jimbro1000/SuperSamFPGA/SuperSamFPGA.png

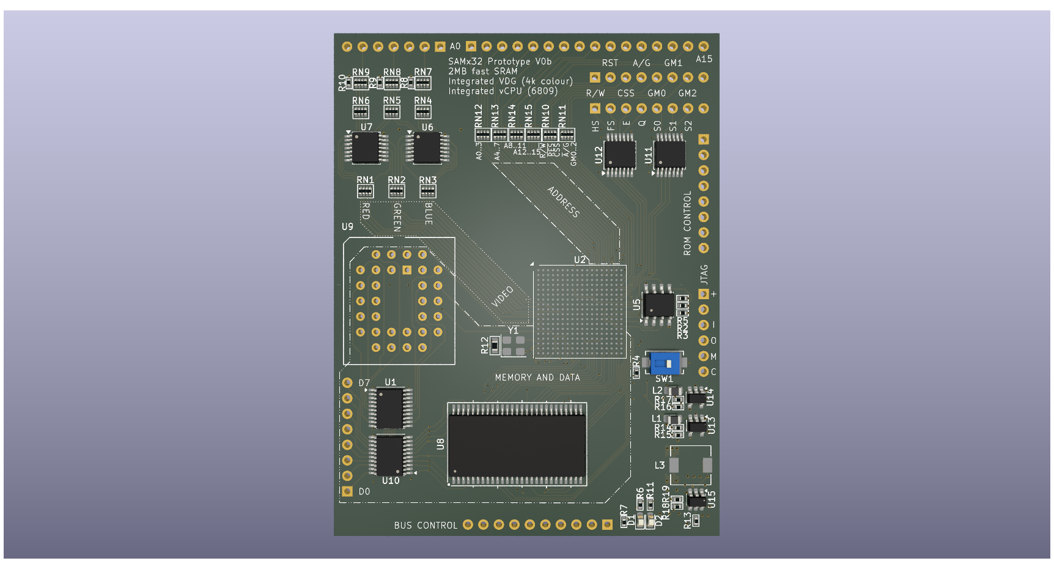
SuperSamFPGA.png
