jimbro1000/SuperSamFPGA/Library.3dModels/RGY0020A.stp

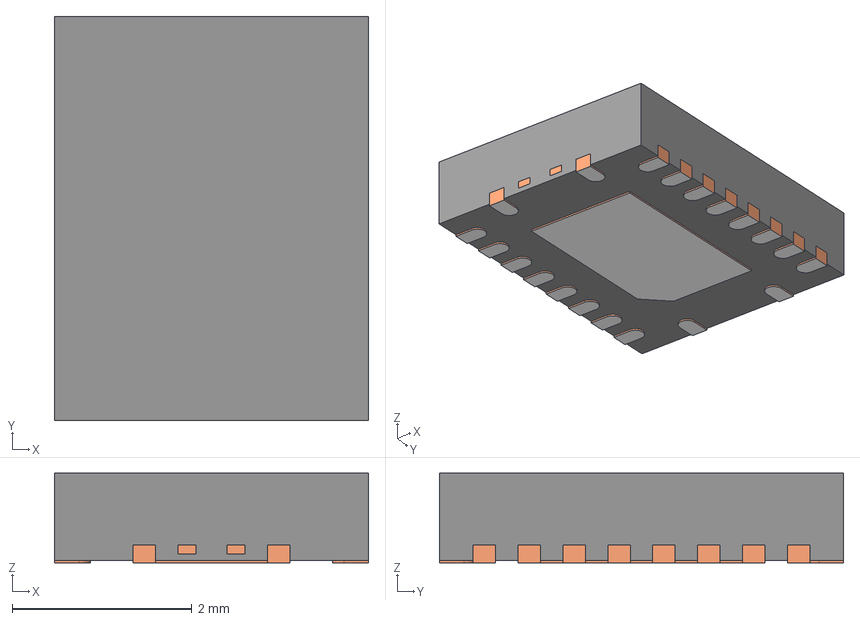
[picture p2: CAD file, 2026-04-23]
Library.3dModels/RGY0020A.stp
3.50 x 4.50 x 1.00 mm
BODY-QFN
FRAME-RGY0020A
PIN1-ID
