jimbro1000/SuperSamFPGA/Library.3dModels/MD-40SM.step

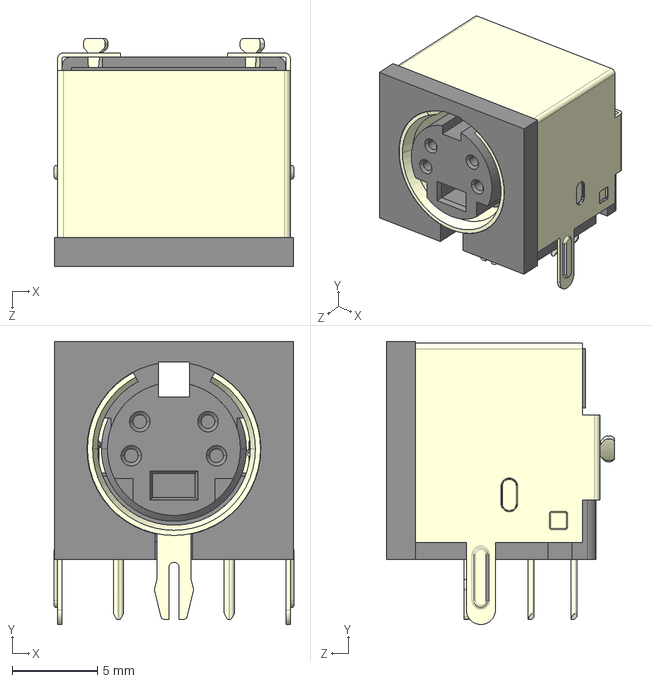
[picture p3: CAD file, 2026-04-23]
Library.3dModels/MD-40SM.step
14.1 x 16.6 x 13.4 mm
