jimbro1000/SuperSamFPGA/Library.3dModels/PW0014A.stp

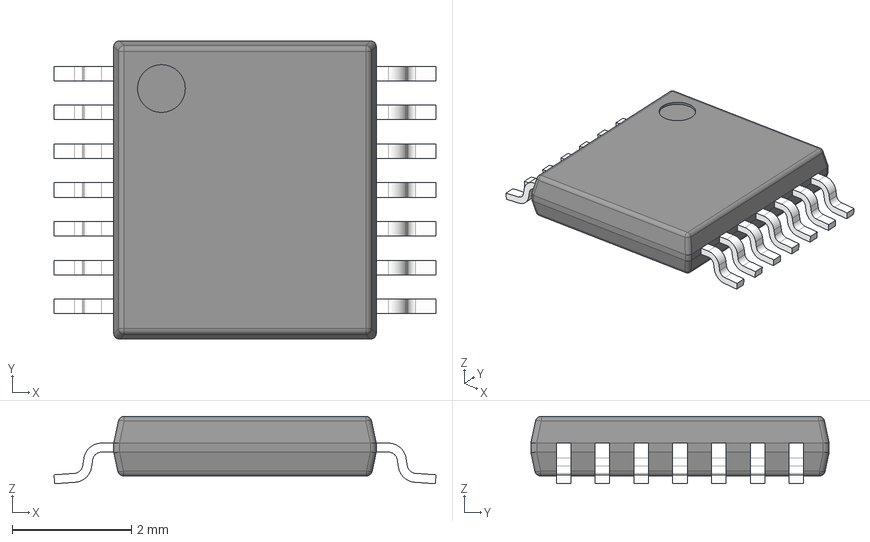
[picture p4: CAD file, 2026-04-23]
Library.3dModels/PW0014A.stp
6.40 x 5.00 x 1.13 mm
BODY-TSSOP
LEAD-TSSOP x 14
PIN1
