jimbro1000/SuperSamFPGA/Library.3dModels/c-7-1734774-3-f-3d.stp

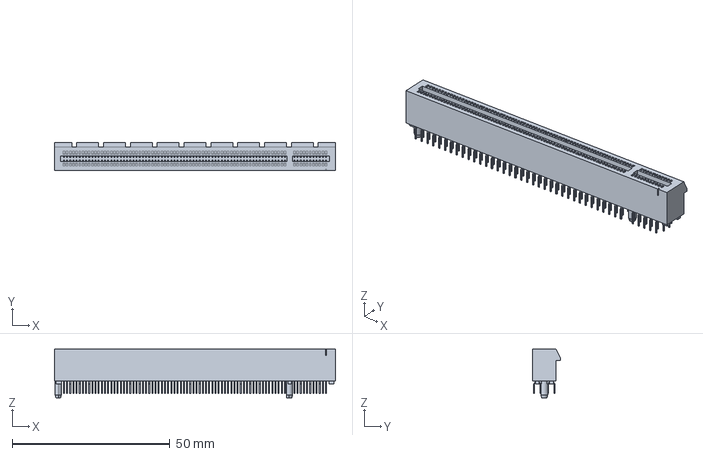
[picture p5: CAD file, 2026-04-23]
Library.3dModels/c-7-1734774-3-f-3d.stp
89.0 x 8.80 x 15.4 mm
