jimbro1000/SuperSamFPGA/SuperSamFPGA.kicad_pcb

## KiCad design SuperSamFPGA.kicad_pcb (2026-04-25)

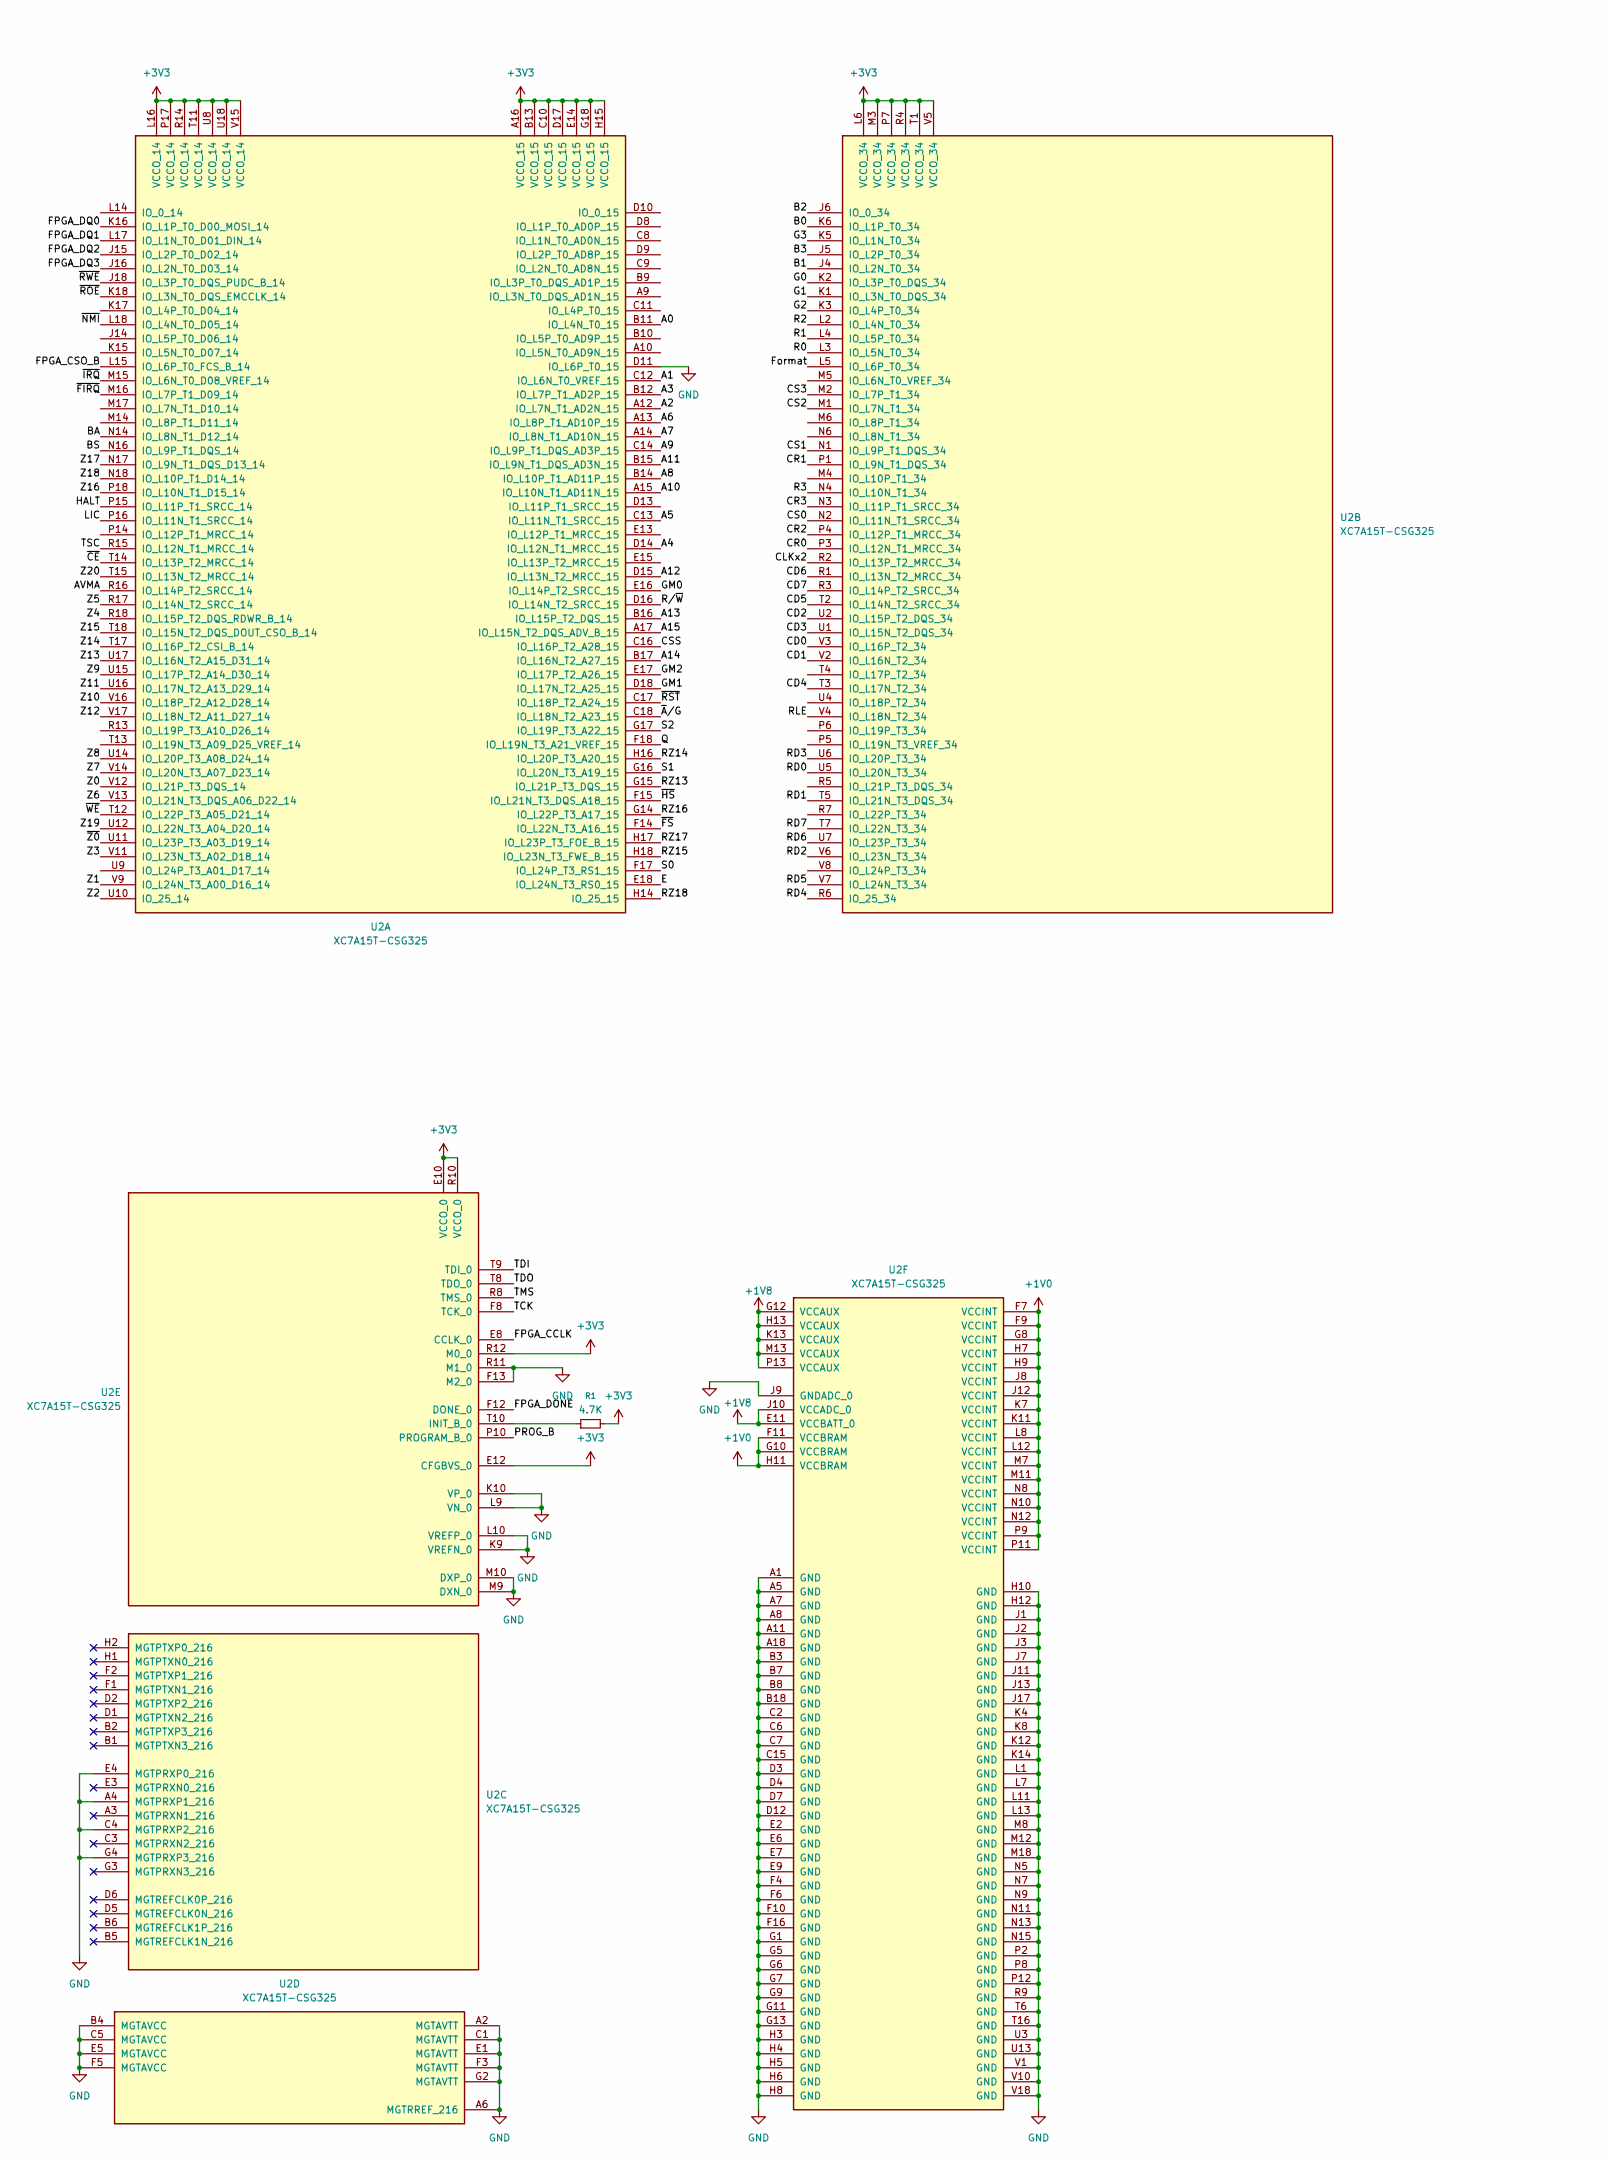
[picture p6: schematic SuperSamFPGA.kicad_sch, part in row 1, column 1]

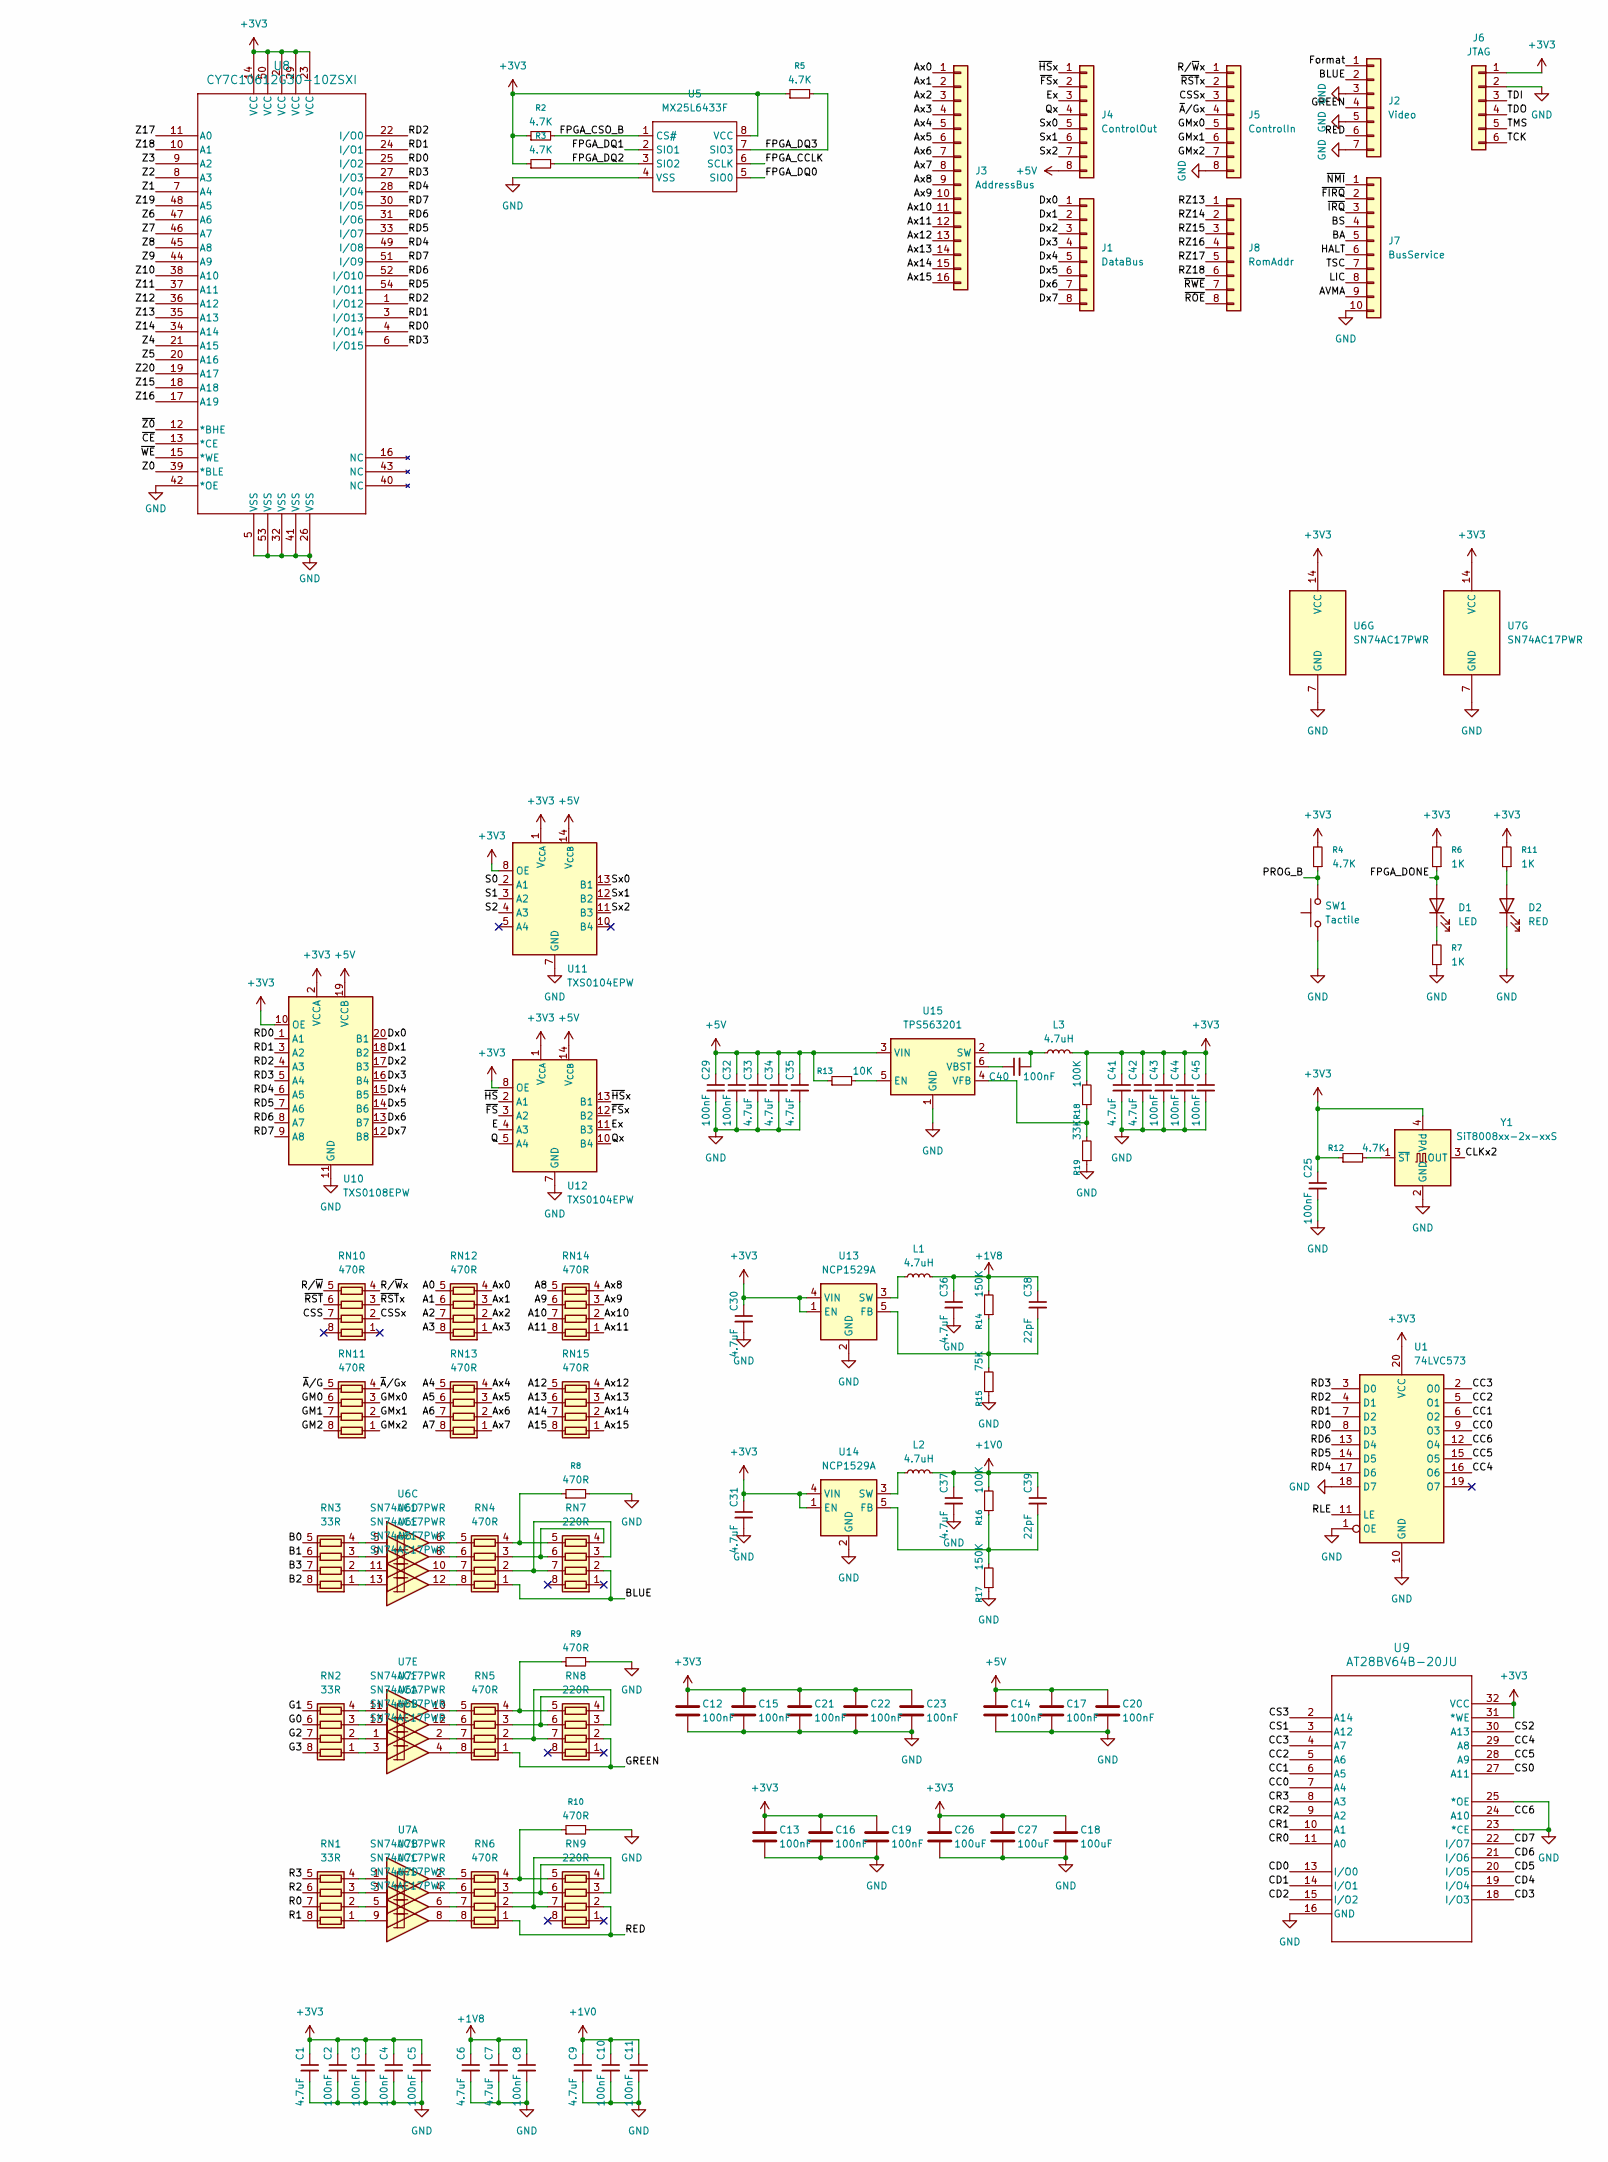
[picture p7: schematic SuperSamFPGA.kicad_sch, part in row 1, column 2]

Parts:
C1, C6, C7, C9, C30, C31, C33, C34, C35, C36, C37, C41, C42: 4.7uF; C_0603_1608Metric; LCSC C1705
C2, C3, C4, C5, C8, C10, C11, C25, C29, C32, C40, C43, C44, C45: 100nF; C_0402_1005Metric; LCSC C1525
C12, C13, C14, C15, C16, C17, C19, C20, C21, C22, C23: 100nF; C_0402_1005Metric; JLCPCB BOM 0
C18, C26, C27: 100uF; C_0805_2012Metric; JLCPCB BOM 0
C38, C39: 22pF; C_0402_1005Metric; LCSC C1555
D1: LED; LED_0603_1608Metric; LCSC C51933298
D2: RED; LED_0603_1608Metric; LCSC C2286
J1: DataBus; PinHeader_1x08_P2.54mm_Vertical
J2: Video; PinHeader_1x07_P2.54mm_Vertical
J3: AddressBus; PinHeader_1x16_P2.54mm_Vertical
J4: ControlOut; PinHeader_1x08_P2.54mm_Vertical
J5: ControlIn; PinHeader_1x08_P2.54mm_Vertical
J6: JTAG; PinHeader_1x06_P2.54mm_Vertical
J7: BusService; PinHeader_1x10_P2.54mm_Vertical
J8: RomAddr; PinHeader_1x08_P2.54mm_Vertical
L1, L2: 4.7uH; L_0805_2012Metric; LCSC C86090
L3: 4.7uH; L_6.3x6.3_H3; LCSC C703091
R1, R2, R3, R4, R5: 4.7K; R_0402_1005Metric; LCSC C105871
R6, R7, R11: 1K; R_0402_1005Metric; LCSC C11702
R8, R9, R10: 470R; R_0402_1005Metric; LCSC C60490
R12: 4.7K; R_0603_1608Metric; LCSC C23162
R13: 10K; R_0402_1005Metric; LCSC C191123
R14, R17: 150K; R_0402_1005Metric; LCSC C93947
R15: 75K; R_0402_1005Metric; LCSC C25798
R16, R18: 100K; R_0402_1005Metric; LCSC C60491
R19: 33K; R_0402_1005Metric; LCSC C25779
RN1, RN2, RN3: 33R; R_Array_Convex_4x0402; LCSC C25501
RN4, RN5, RN6, RN10, RN11, RN12, RN13, RN14, RN15: 470R; R_Array_Convex_4x0402; LCSC C425292
RN7, RN8, RN9: 220R; R_Array_Convex_4x0402; LCSC C25498
SW1: Tactile; SW_SPST_EVQPE1; LCSC C49108628
U1: 74LVC573; TSSOP-20_4.4x6.5mm_P0.65mm; LCSC C6096
U2: XC7A15T-CSG325; BGA-324_15x15mm_Layout18x18_P0.8mm; LCSC C1551978
U5: MX25L6433F; SO-8_3.9x4.9mm_P1.27mm; LCSC C706695
U6, U7: SN74AC17PWR; TSSOP-14_4.4x5mm_P0.65mm; LCSC C44842197
U8: CY7C10612G30-10ZSXI; TSOP-II-54_22.2x10.16mm_P0.8mm
U9: AT28BV64B-20JU; PLCC-32_THT-Socket
U10: TXS0108EPW; TSSOP-20_4.4x6.5mm_P0.65mm; LCSC C17206
U11, U12: TXS0104EPW; TSSOP-14_4.4x5mm_P0.65mm; LCSC C44955
U13, U14: NCP1529A; SOT-23-5; LCSC C49375212
U15: TPS563201; SOT-23-6; LCSC C116592
Y1: SiT8008xx-2x-xxS; Oscillator_SMD_SiT_PQFN-4Pin_3.2x2.5mm; LCSC C2901579

Connections:
+1V0: C9.1, C10.1, C11.1, C37.1, C39.1, L2.2, R16.2, U2.F7 (VCCINT), U2.F9 (VCCINT), U2.F11 (VCCBRAM), U2.G8 (VCCINT), U2.G10 (VCCBRAM), U2.H7 (VCCINT), U2.H9 (VCCINT), U2.H11 (VCCBRAM), U2.J8 (VCCINT), U2.J12 (VCCINT), U2.K7 (VCCINT), U2.K11 (VCCINT), U2.L8 (VCCINT), U2.L12 (VCCINT), U2.M7 (VCCINT), U2.M11 (VCCINT), U2.N8 (VCCINT), U2.N10 (VCCINT), U2.N12 (VCCINT), U2.P9 (VCCINT), U2.P11 (VCCINT)
+1V8: C6.1, C7.1, C8.1, C36.1, C38.1, L1.2, R14.2, U2.E11 (VCCBATT_0), U2.G12 (VCCAUX), U2.H13 (VCCAUX), U2.J10 (VCCADC_0), U2.K13 (VCCAUX), U2.M13 (VCCAUX), U2.P13 (VCCAUX)
+3V3: C1.1, C2.1, C3.1, C4.1, C5.1, C12.1, C13.1, C15.1, C16.1, C18.1, C19.1, C21.1, C22.1, C23.1, C25.1, C26.1, C27.1, C30.1, C31.1, C41.1, C42.1, C43.1, C44.1, C45.1, J6.1, L3.2, R1.2, R2.1, R3.1, R4.2, R5.1, R6.2, R11.2, R12.1, R18.2, U1.20 (VCC), U2.A16 (VCCO_15), U2.B13 (VCCO_15), U2.C10 (VCCO_15), U2.D17 (VCCO_15), U2.E10 (VCCO_0), U2.E12 (CFGBVS_0), U2.E14 (VCCO_15), U2.G18 (VCCO_15), U2.H15 (VCCO_15), U2.L6 (VCCO_34), U2.L16 (VCCO_14), U2.M3 (VCCO_34), U2.P7 (VCCO_34), U2.P17 (VCCO_14), U2.R4 (VCCO_34), U2.R10 (VCCO_0), U2.R12 (M0_0), U2.R14 (VCCO_14), U2.T1 (VCCO_34), U2.T11 (VCCO_14), U2.U8 (VCCO_14), U2.U18 (VCCO_14), U2.V5 (VCCO_34), U2.V15 (VCCO_14), U5.8 (VCC), U6.14 (VCC), U7.14 (VCC), U8.2 (VCC), U8.14 (VCC), U8.23 (VCC), U8.29 (VCC), U8.50 (VCC), U9.31 (*WE), U9.32 (VCC), U10.2 (VCCA), U10.10 (OE), U11.1 (V_{CCA}), U11.8 (OE), U12.1 (V_{CCA}), U12.8 (OE), U13.1 (EN), U13.4 (VIN), U14.1 (EN), U14.4 (VIN), Y1.4 (Vdd)
+5V: C14.1, C17.1, C20.1, C29.1, C32.1, C33.1, C34.1, C35.1, J4.8, R13.1, U10.19 (VCCB), U11.14 (V_{CCB}), U12.14 (V_{CCB}), U15.3 (VIN)
/A0: RN12.5 (R4.2), U2.B11 (IO_L4N_T0_15)
/A1: RN12.6 (R3.2), U2.C12 (IO_L6N_T0_VREF_15)
/A2: RN12.7 (R2.2), U2.A12 (IO_L7N_T1_AD2N_15)
/A3: RN12.8 (R1.2), U2.B12 (IO_L7P_T1_AD2P_15)
/A4: RN13.5 (R4.2), U2.D14 (IO_L12N_T1_MRCC_15)
/A5: RN13.6 (R3.2), U2.C13 (IO_L11N_T1_SRCC_15)
/A6: RN13.7 (R2.2), U2.A13 (IO_L8P_T1_AD10P_15)
/A7: RN13.8 (R1.2), U2.A14 (IO_L8N_T1_AD10N_15)
/A8: RN14.5 (R4.2), U2.B14 (IO_L10P_T1_AD11P_15)
/A9: RN14.6 (R3.2), U2.C14 (IO_L9P_T1_DQS_AD3P_15)
/A10: RN14.7 (R2.2), U2.A15 (IO_L10N_T1_AD11N_15)
/A11: RN14.8 (R1.2), U2.B15 (IO_L9N_T1_DQS_AD3N_15)
/A12: RN15.5 (R4.2), U2.D15 (IO_L13N_T2_MRCC_15)
/A13: RN15.6 (R3.2), U2.B16 (IO_L15P_T2_DQS_15)
/A14: RN15.7 (R2.2), U2.B17 (IO_L16N_T2_A27_15)
/A15: RN15.8 (R1.2), U2.A17 (IO_L15N_T2_DQS_ADV_B_15)
/AVMA: J7.9, U2.R16 (IO_L14P_T2_SRCC_14)
/Ax0: J3.1, RN12.4 (R4.1)
/Ax1: J3.2, RN12.3 (R3.1)
/Ax2: J3.3, RN12.2 (R2.1)
/Ax3: J3.4, RN12.1 (R1.1)
/Ax4: J3.5, RN13.4 (R4.1)
/Ax5: J3.6, RN13.3 (R3.1)
/Ax6: J3.7, RN13.2 (R2.1)
/Ax7: J3.8, RN13.1 (R1.1)
/Ax8: J3.9, RN14.4 (R4.1)
/Ax9: J3.10, RN14.3 (R3.1)
/Ax10: J3.11, RN14.2 (R2.1)
/Ax11: J3.12, RN14.1 (R1.1)
/Ax12: J3.13, RN15.4 (R4.1)
/Ax13: J3.14, RN15.3 (R3.1)
/Ax14: J3.15, RN15.2 (R2.1)
/Ax15: J3.16, RN15.1 (R1.1)
/B0: RN3.5 (R4.2), U2.K6 (IO_L1P_T0_34)
/B1: RN3.6 (R3.2), U2.J4 (IO_L2N_T0_34)
/B2: RN3.8 (R1.2), U2.J6 (IO_0_34)
/B3: RN3.7 (R2.2), U2.J5 (IO_L2P_T0_34)
/BA: J7.5, U2.N14 (IO_L8N_T1_D12_14)
/BLUE: J2.2, RN4.1 (R1.1), RN7.2 (R2.1)
/BS: J7.4, U2.N16 (IO_L9P_T1_DQS_14)
/CC0: U1.9 (O3), U9.7 (A4)
/CC1: U1.6 (O2), U9.6 (A5)
/CC2: U1.5 (O1), U9.5 (A6)
/CC3: U1.2 (O0), U9.4 (A7)
/CC4: U1.16 (O6), U9.29 (A8)
/CC5: U1.15 (O5), U9.28 (A9)
/CC6: U1.12 (O4), U9.24 (A10)
/CD0: U2.V3 (IO_L16P_T2_34), U9.13 (I/O0)
/CD1: U2.V2 (IO_L16N_T2_34), U9.14 (I/O1)
/CD2: U2.U2 (IO_L15P_T2_DQS_34), U9.15 (I/O2)
/CD3: U2.U1 (IO_L15N_T2_DQS_34), U9.18 (I/O3)
/CD4: U2.T3 (IO_L17N_T2_34), U9.19 (I/O4)
/CD5: U2.T2 (IO_L14N_T2_SRCC_34), U9.20 (I/O5)
/CD6: U2.R1 (IO_L13N_T2_MRCC_34), U9.21 (I/O6)
/CD7: U2.R3 (IO_L14P_T2_SRCC_34), U9.22 (I/O7)
/CLKx2: U2.R2 (IO_L13P_T2_MRCC_34), Y1.3 (OUT)
/CR0: U2.P3 (IO_L12N_T1_MRCC_34), U9.11 (A0)
/CR1: U2.P1 (IO_L9N_T1_DQS_34), U9.10 (A1)
/CR2: U2.P4 (IO_L12P_T1_MRCC_34), U9.9 (A2)
/CR3: U2.N3 (IO_L11P_T1_SRCC_34), U9.8 (A3)
/CS0: U2.N2 (IO_L11N_T1_SRCC_34), U9.27 (A11)
/CS1: U2.N1 (IO_L9P_T1_DQS_34), U9.3 (A12)
/CS2: U2.M1 (IO_L7N_T1_34), U9.30 (A13)
/CS3: U2.M2 (IO_L7P_T1_34), U9.2 (A14)
/CSS: RN10.7 (R2.2), U2.C16 (IO_L16P_T2_A28_15)
/CSSx: J5.3, RN10.2 (R2.1)
/Dx0: J1.1, U10.20 (B1)
/Dx1: J1.2, U10.18 (B2)
/Dx2: J1.3, U10.17 (B3)
/Dx3: J1.4, U10.16 (B4)
/Dx4: J1.5, U10.15 (B5)
/Dx5: J1.6, U10.14 (B6)
/Dx6: J1.7, U10.13 (B7)
/Dx7: J1.8, U10.12 (B8)
/E: U2.E18 (IO_L24N_T3_RS0_15), U12.4 (A3)
/Ex: J4.3, U12.11 (B3)
/FPGA_CCLK: U2.E8 (CCLK_0), U5.6 (SCLK)
/FPGA_CSO_B: R2.2, U2.L15 (IO_L6P_T0_FCS_B_14), U5.1 (CS#)
/FPGA_DONE: D1.2 (A), R6.1, U2.F12 (DONE_0)
/FPGA_DQ0: U2.K16 (IO_L1P_T0_D00_MOSI_14), U5.5 (SIO0)
/FPGA_DQ1: U2.L17 (IO_L1N_T0_D01_DIN_14), U5.2 (SIO1)
/FPGA_DQ2: R3.2, U2.J15 (IO_L2P_T0_D02_14), U5.3 (SIO2)
/FPGA_DQ3: R5.2, U2.J16 (IO_L2N_T0_D03_14), U5.7 (SIO3)
/Format: J2.1, U2.L5 (IO_L6P_T0_34)
/G0: RN2.6 (R3.2), U2.K2 (IO_L3P_T0_DQS_34)
/G1: RN2.5 (R4.2), U2.K1 (IO_L3N_T0_DQS_34)
/G2: RN2.7 (R2.2), U2.K3 (IO_L4P_T0_34)
/G3: RN2.8 (R1.2), U2.K5 (IO_L1N_T0_34)
/GM0: RN11.6 (R3.2), U2.E16 (IO_L14P_T2_SRCC_15)
/GM1: RN11.7 (R2.2), U2.D18 (IO_L17N_T2_A25_15)
/GM2: RN11.8 (R1.2), U2.E17 (IO_L17P_T2_A26_15)
/GMx0: J5.5, RN11.3 (R3.1)
/GMx1: J5.6, RN11.2 (R2.1)
/GMx2: J5.7, RN11.1 (R1.1)
/GREEN: J2.4, RN5.1 (R1.1), RN8.2 (R2.1)
/HALT: J7.6, U2.P15 (IO_L11P_T1_SRCC_14)
/LIC: J7.8, U2.P16 (IO_L11N_T1_SRCC_14)
/PROG_B: R4.1, SW1.2, U2.P10 (PROGRAM_B_0)
/Q: U2.F18 (IO_L19N_T3_A21_VREF_15), U12.5 (A4)
/Qx: J4.4, U12.10 (B4)
/R0: RN1.7 (R2.2), U2.L3 (IO_L5N_T0_34)
/R1: RN1.8 (R1.2), U2.L4 (IO_L5P_T0_34)
/R2: RN1.6 (R3.2), U2.L2 (IO_L4N_T0_34)
/R3: RN1.5 (R4.2), U2.N4 (IO_L10N_T1_34)
/RD0: U1.8 (D3), U2.U5 (IO_L20N_T3_34), U8.4 (I/O14), U8.25 (I/O2), U10.1 (A1)
/RD1: U1.7 (D2), U2.T5 (IO_L21N_T3_DQS_34), U8.3 (I/O13), U8.24 (I/O1), U10.3 (A2)
/RD2: U1.4 (D1), U2.V6 (IO_L23N_T3_34), U8.1 (I/O12), U8.22 (I/O0), U10.4 (A3)
/RD3: U1.3 (D0), U2.U6 (IO_L20P_T3_34), U8.6 (I/O15), U8.27 (I/O3), U10.5 (A4)
/RD4: U1.17 (D6), U2.R6 (IO_25_34), U8.28 (I/O4), U8.49 (I/O8), U10.6 (A5)
/RD5: U1.14 (D5), U2.V7 (IO_L24N_T3_34), U8.33 (I/O7), U8.54 (I/O11), U10.7 (A6)
/RD6: U1.13 (D4), U2.U7 (IO_L23P_T3_34), U8.31 (I/O6), U8.52 (I/O10), U10.8 (A7)
/RD7: U2.T7 (IO_L22N_T3_34), U8.30 (I/O5), U8.51 (I/O9), U10.9 (A8)
/RED: J2.6, RN6.1 (R1.1), RN9.2 (R2.1)
/RLE: U1.11 (LE), U2.V4 (IO_L18N_T2_34)
/RZ13: J8.1, U2.G15 (IO_L21P_T3_DQS_15)
/RZ14: J8.2, U2.H16 (IO_L20P_T3_A20_15)
/RZ15: J8.3, U2.H18 (IO_L23N_T3_FWE_B_15)
/RZ16: J8.4, U2.G14 (IO_L22P_T3_A17_15)
/RZ17: J8.5, U2.H17 (IO_L23P_T3_FOE_B_15)
/RZ18: J8.6, U2.H14 (IO_25_15)
/R/~W: RN10.5 (R4.2), U2.D16 (IO_L14N_T2_SRCC_15)
/R/~Wx: J5.1, RN10.4 (R4.1)
/S0: U2.F17 (IO_L24P_T3_RS1_15), U11.2 (A1)
/S1: U2.G16 (IO_L20N_T3_A19_15), U11.3 (A2)
/S2: U2.G17 (IO_L19P_T3_A22_15), U11.4 (A3)
/Sx0: J4.5, U11.13 (B1)
/Sx1: J4.6, U11.12 (B2)
/Sx2: J4.7, U11.11 (B3)
/TCK: J6.6, U2.F8 (TCK_0)
/TDI: J6.3, U2.T9 (TDI_0)
/TDO: J6.4, U2.T8 (TDO_0)
/TMS: J6.5, U2.R8 (TMS_0)
/TSC: J7.7, U2.R15 (IO_L12N_T1_MRCC_14)
/Z0: U2.V12 (IO_L21P_T3_DQS_14), U8.39 (*BLE)
/Z1: U2.V9 (IO_L24N_T3_A00_D16_14), U8.7 (A4)
/Z2: U2.U10 (IO_25_14), U8.8 (A3)
/Z3: U2.V11 (IO_L23N_T3_A02_D18_14), U8.9 (A2)
/Z4: U2.R18 (IO_L15P_T2_DQS_RDWR_B_14), U8.21 (A15)
/Z5: U2.R17 (IO_L14N_T2_SRCC_14), U8.20 (A16)
/Z6: U2.V13 (IO_L21N_T3_DQS_A06_D22_14), U8.47 (A6)
/Z7: U2.V14 (IO_L20N_T3_A07_D23_14), U8.46 (A7)
/Z8: U2.U14 (IO_L20P_T3_A08_D24_14), U8.45 (A8)
/Z9: U2.U15 (IO_L17P_T2_A14_D30_14), U8.44 (A9)
/Z10: U2.V16 (IO_L18P_T2_A12_D28_14), U8.38 (A10)
/Z11: U2.U16 (IO_L17N_T2_A13_D29_14), U8.37 (A11)
/Z12: U2.V17 (IO_L18N_T2_A11_D27_14), U8.36 (A12)
/Z13: U2.U17 (IO_L16N_T2_A15_D31_14), U8.35 (A13)
/Z14: U2.T17 (IO_L16P_T2_CSI_B_14), U8.34 (A14)
/Z15: U2.T18 (IO_L15N_T2_DQS_DOUT_CSO_B_14), U8.18 (A18)
/Z16: U2.P18 (IO_L10N_T1_D15_14), U8.17 (A19)
/Z17: U2.N17 (IO_L9N_T1_DQS_D13_14), U8.11 (A0)
/Z18: U2.N18 (IO_L10P_T1_D14_14), U8.10 (A1)
/Z19: U2.U12 (IO_L22N_T3_A04_D20_14), U8.48 (A5)
/Z20: U2.T15 (IO_L13N_T2_MRCC_14), U8.19 (A17)
/~A/G: RN11.5 (R4.2), U2.C18 (IO_L18N_T2_A23_15)
/~A/Gx: J5.4, RN11.4 (R4.1)
/~CE: U2.T14 (IO_L13P_T2_MRCC_14), U8.13 (*CE)
/~FIRQ: J7.2, U2.M16 (IO_L7P_T1_D09_14)
/~FS: U2.F14 (IO_L22N_T3_A16_15), U12.3 (A2)
/~FSx: J4.2, U12.12 (B2)
/~HS: U2.F15 (IO_L21N_T3_DQS_A18_15), U12.2 (A1)
/~HSx: J4.1, U12.13 (B1)
/~IRQ: J7.3, U2.M15 (IO_L6N_T0_D08_VREF_14)
/~NMI: J7.1, U2.L18 (IO_L4N_T0_D05_14)
/~ROE: J8.8, U2.K18 (IO_L3N_T0_DQS_EMCCLK_14)
/~RST: RN10.6 (R3.2), U2.C17 (IO_L18P_T2_A24_15)
/~RSTx: J5.2, RN10.3 (R3.1)
/~RWE: J8.7, U2.J18 (IO_L3P_T0_DQS_PUDC_B_14)
/~WE: U2.T12 (IO_L22P_T3_A05_D21_14), U8.15 (*WE)
/~Z0: U2.U11 (IO_L23P_T3_A03_D19_14), U8.12 (*BHE)
GND: C1.2, C2.2, C3.2, C4.2, C5.2, C6.2, C7.2, C8.2, C9.2, C10.2, C11.2, C12.2, C13.2, C14.2, C15.2, C16.2, C17.2, C18.2, C19.2, C20.2, C21.2, C22.2, C23.2, C25.2, C26.2, C27.2, C29.2, C30.2, C31.2, C32.2, C33.2, C34.2, C35.2, C36.2, C37.2, C41.2, C42.2, C43.2, C44.2, C45.2, D2.1 (K), J2.3, J2.5, J2.7, J5.8, J6.2, J7.10, R7.1, R8.2, R9.2, R10.2, R15.1, R17.1, R19.1, SW1.1, U1.1 (OE), U1.10 (GND), U1.18 (D7), U2.A1 (GND), U2.A2 (MGTAVTT), U2.A4 (MGTPRXP1_216), U2.A5 (GND), U2.A6 (MGTRREF_216), U2.A7 (GND), U2.A8 (GND), U2.A11 (GND), U2.A18 (GND), U2.B3 (GND), U2.B4 (MGTAVCC), U2.B7 (GND), U2.B8 (GND), U2.B18 (GND), U2.C1 (MGTAVTT), U2.C2 (GND), U2.C4 (MGTPRXP2_216), U2.C5 (MGTAVCC), U2.C6 (GND), U2.C7 (GND), U2.C15 (GND), U2.D3 (GND), U2.D4 (GND), U2.D7 (GND), U2.D11 (IO_L6P_T0_15), U2.D12 (GND), U2.E1 (MGTAVTT), U2.E2 (GND), U2.E4 (MGTPRXP0_216), U2.E5 (MGTAVCC), U2.E6 (GND), U2.E7 (GND), U2.E9 (GND), U2.F3 (MGTAVTT), U2.F4 (GND), U2.F5 (MGTAVCC), U2.F6 (GND), U2.F10 (GND), U2.F13 (M2_0), U2.F16 (GND), U2.G1 (GND), U2.G2 (MGTAVTT), U2.G4 (MGTPRXP3_216), U2.G5 (GND), U2.G6 (GND), U2.G7 (GND), U2.G9 (GND), U2.G11 (GND), U2.G13 (GND), U2.H3 (GND), U2.H4 (GND), U2.H5 (GND), U2.H6 (GND), U2.H8 (GND), U2.H10 (GND), U2.H12 (GND), U2.J1 (GND), U2.J2 (GND), U2.J3 (GND), U2.J7 (GND), U2.J9 (GNDADC_0), U2.J11 (GND), U2.J13 (GND), U2.J17 (GND), U2.K4 (GND), U2.K8 (GND), U2.K9 (VREFN_0), U2.K10 (VP_0), U2.K12 (GND), U2.K14 (GND), U2.L1 (GND), U2.L7 (GND), U2.L9 (VN_0), U2.L10 (VREFP_0), U2.L11 (GND), U2.L13 (GND), U2.M8 (GND), U2.M9 (DXN_0), U2.M10 (DXP_0), U2.M12 (GND), U2.M18 (GND), U2.N5 (GND), U2.N7 (GND), U2.N9 (GND), U2.N11 (GND), U2.N13 (GND), U2.N15 (GND), U2.P2 (GND), U2.P8 (GND), U2.P12 (GND), U2.R9 (GND), U2.R11 (M1_0), U2.T6 (GND), U2.T16 (GND), U2.U3 (GND), U2.U13 (GND), U2.V1 (GND), U2.V10 (GND), U2.V18 (GND), U5.4 (VSS), U6.7 (GND), U7.7 (GND), U8.5 (VSS), U8.26 (VSS), U8.32 (VSS), U8.41 (VSS), U8.42 (*OE), U8.53 (VSS), U9.16 (GND), U9.23 (*CE), U9.25 (*OE), U10.11 (GND), U11.7 (GND), U12.7 (GND), U13.2 (GND), U14.2 (GND), U15.1 (GND), Y1.2 (GND)
unnamed: D1.1 (K), R7.2
unnamed: D2.2 (A), R11.1
unnamed: RN1.1 (R1.1), U7.9
unnamed: RN1.2 (R2.1), U7.5
unnamed: RN1.3 (R3.1), U7.3
unnamed: RN1.4 (R4.1), U7.1
unnamed: RN2.1 (R1.1), U6.3
unnamed: RN2.2 (R2.1), U6.1
unnamed: RN2.3 (R3.1), U7.13
unnamed: RN2.4 (R4.1), U7.11
unnamed: RN3.1 (R1.1), U6.13
unnamed: RN3.2 (R2.1), U6.11
unnamed: RN3.3 (R3.1), U6.9
unnamed: RN3.4 (R4.1), U6.5
unnamed: RN4.8 (R1.2), U6.12
unnamed: RN4.2 (R2.1), RN7.3 (R3.1), RN7.7 (R2.2)
unnamed: RN4.7 (R2.2), U6.10
unnamed: RN4.3 (R3.1), RN7.4 (R4.1), RN7.6 (R3.2)
unnamed: RN4.6 (R3.2), U6.8
unnamed: R8.1, RN4.4 (R4.1), RN7.5 (R4.2)
unnamed: RN4.5 (R4.2), U6.6
unnamed: RN5.8 (R1.2), U6.4
unnamed: RN5.2 (R2.1), RN8.3 (R3.1), RN8.7 (R2.2)
unnamed: RN5.7 (R2.2), U6.2
unnamed: RN5.3 (R3.1), RN8.4 (R4.1), RN8.6 (R3.2)
unnamed: RN5.6 (R3.2), U7.12
unnamed: R9.1, RN5.4 (R4.1), RN8.5 (R4.2)
unnamed: RN5.5 (R4.2), U7.10
unnamed: RN6.8 (R1.2), U7.8
unnamed: RN6.2 (R2.1), RN9.3 (R3.1), RN9.7 (R2.2)
unnamed: RN6.7 (R2.2), U7.6
unnamed: RN6.3 (R3.1), RN9.4 (R4.1), RN9.6 (R3.2)
unnamed: RN6.6 (R3.2), U7.4
unnamed: R10.1, RN6.4 (R4.1), RN9.5 (R4.2)
unnamed: RN6.5 (R4.2), U7.2
unnamed: R1.1, U2.T10 (INIT_B_0)
unnamed: C38.2, R14.1, R15.2, U13.5 (FB)
unnamed: L1.1, U13.3 (SW)
unnamed: C39.2, R16.1, R17.2, U14.5 (FB)
unnamed: L2.1, U14.3 (SW)
unnamed: R13.2, U15.5 (EN)
unnamed: C40.2, L3.1, U15.2 (SW)
unnamed: C40.1, U15.6 (VBST)
unnamed: R18.1, R19.2, U15.4 (VFB)
unnamed: R12.2, Y1.1 (~ST)

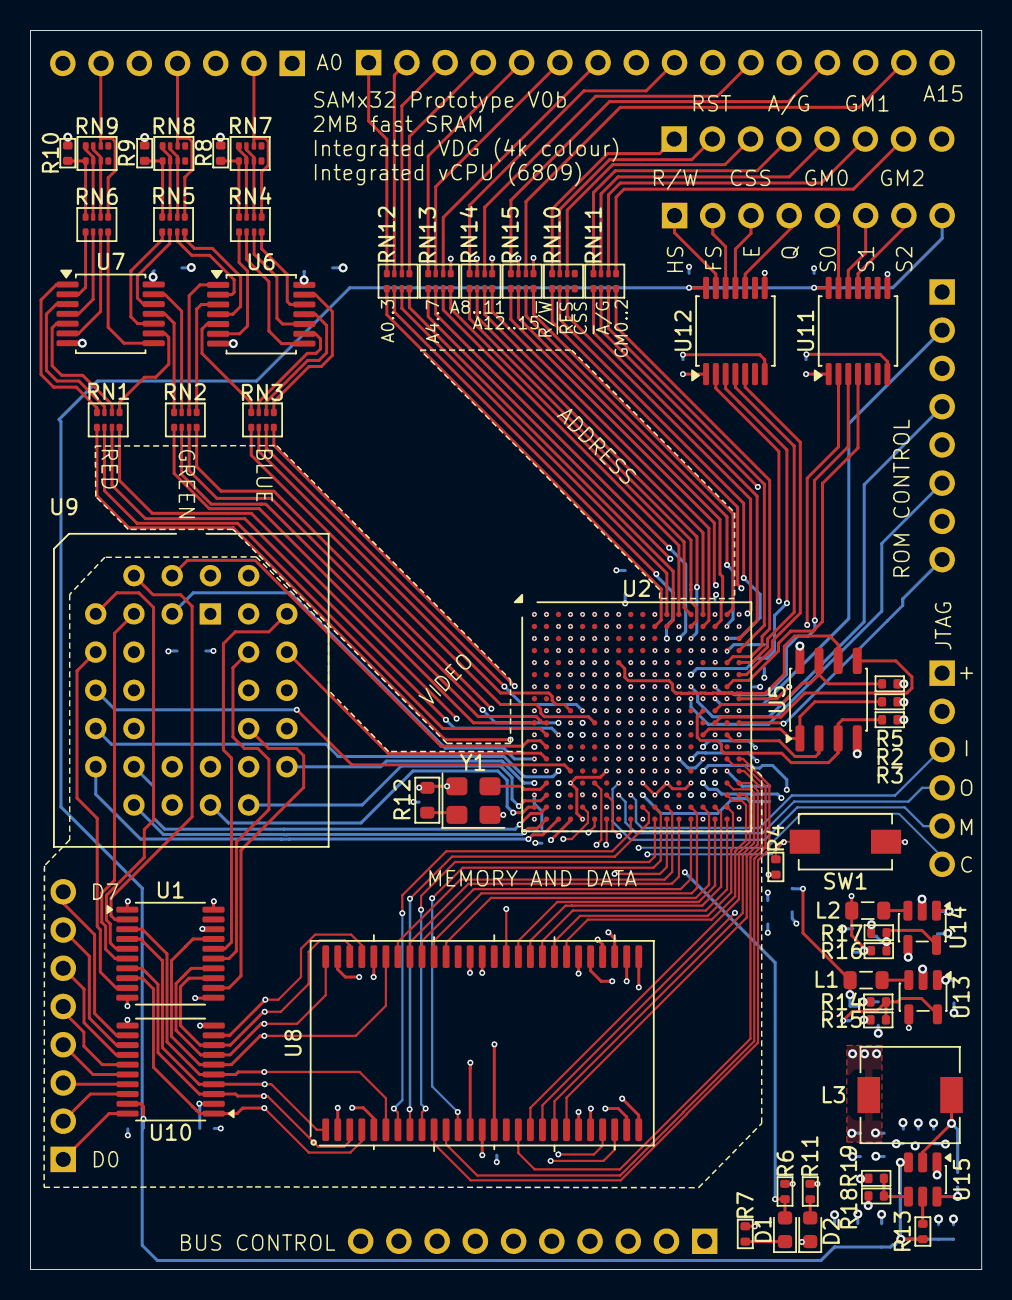
[picture p8: board SuperSamFPGA.kicad_pcb from above]

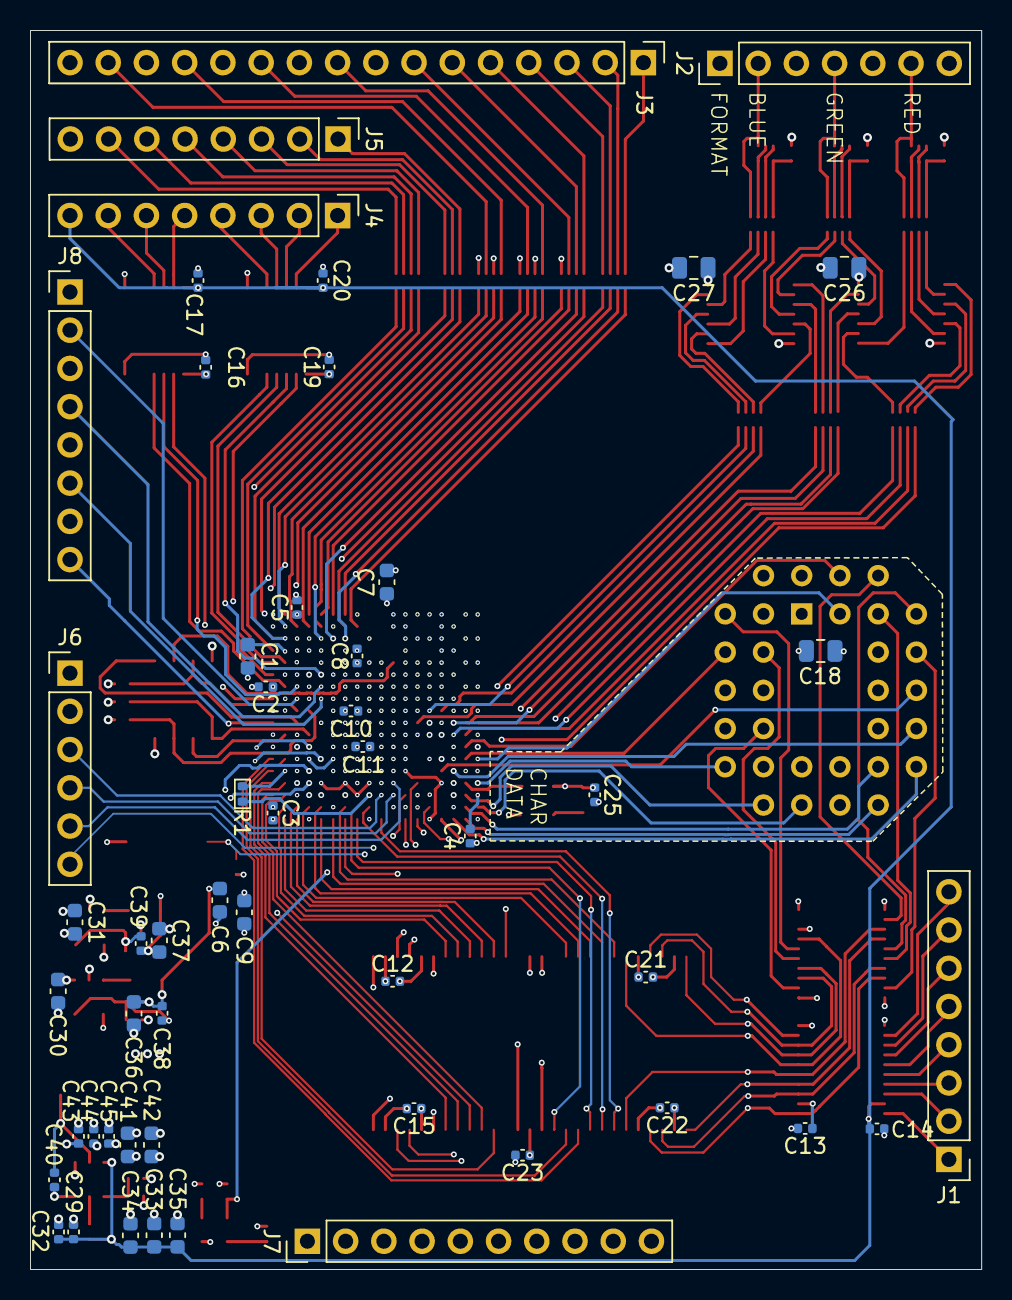
[picture p9: board SuperSamFPGA.kicad_pcb from below]

Board: 6 copper layers, 63.2 x 82.3 mm, 105 parts (52 on the bottom side), 220 nets.
