jimbro1000/SuperSamFPGA/(commit log)

2026-04-25 complete initial design
    [SuperSamFPGA.kicad_pcb, SuperSamFPGA.kicad_sch]
2026-04-25 implement alternative sram
    [SuperSamFPGA.kicad_pcb, SuperSamFPGA.kicad_sch]
